LeoAndGit/Soft_Robot_Controller/PCB/SoftRobotExpansion-01.pdf

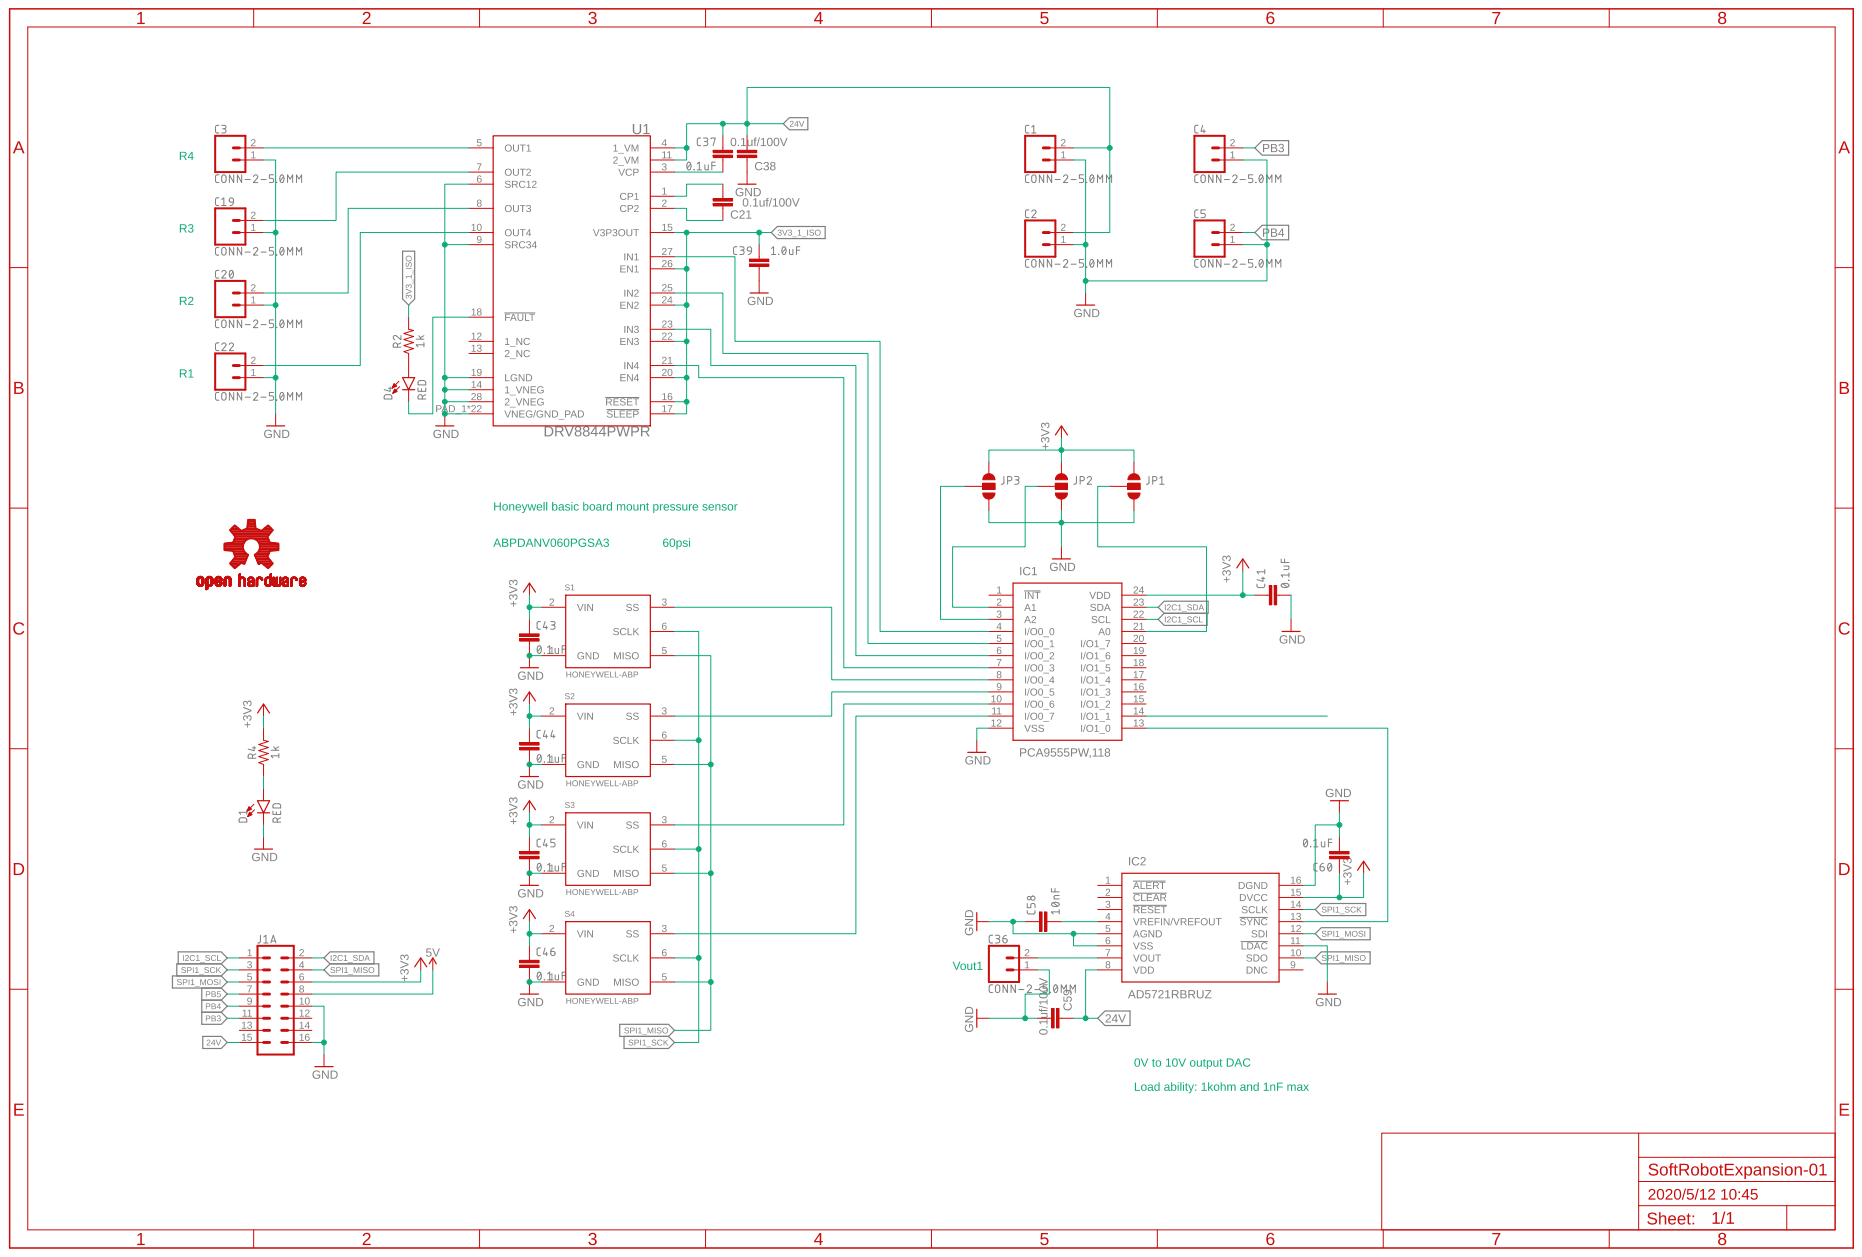
[picture p3: page 1]
