LeoAndGit/Soft_Robot_Controller/PCB/SoftRobotController-01.pdf

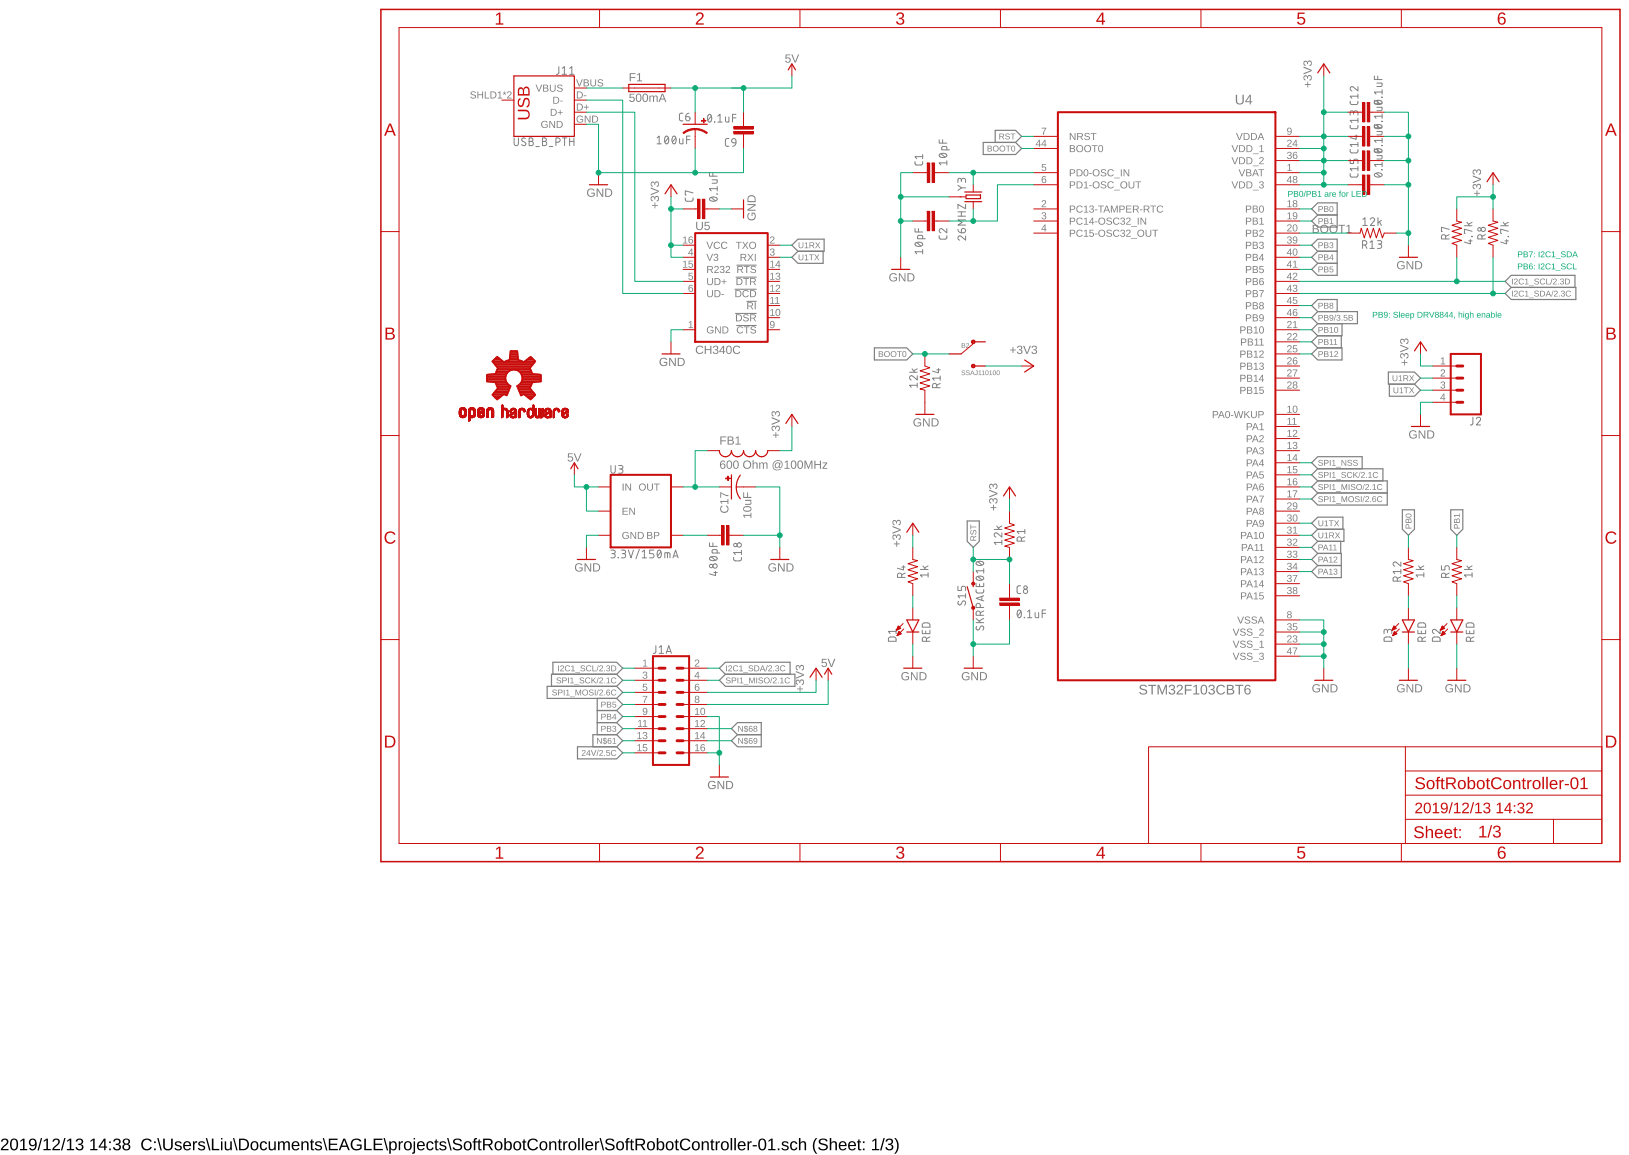
[picture p4: page 1]

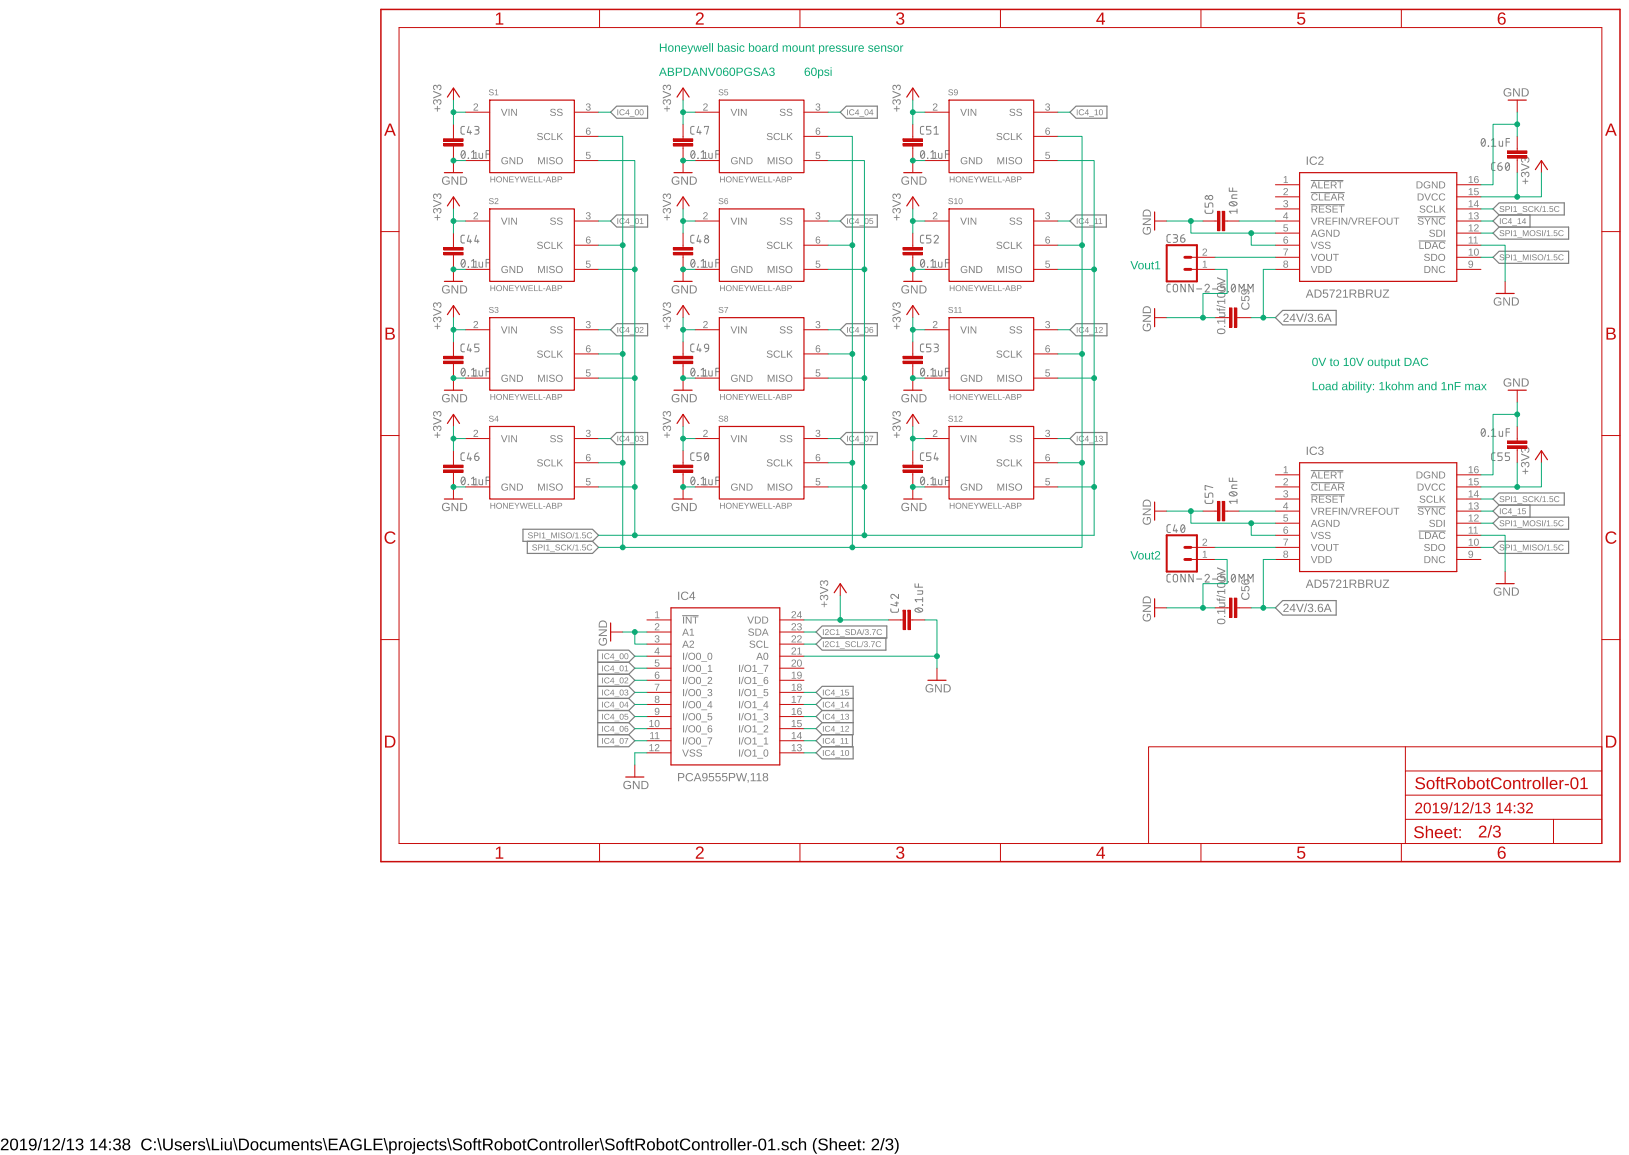
[picture p5: page 2]

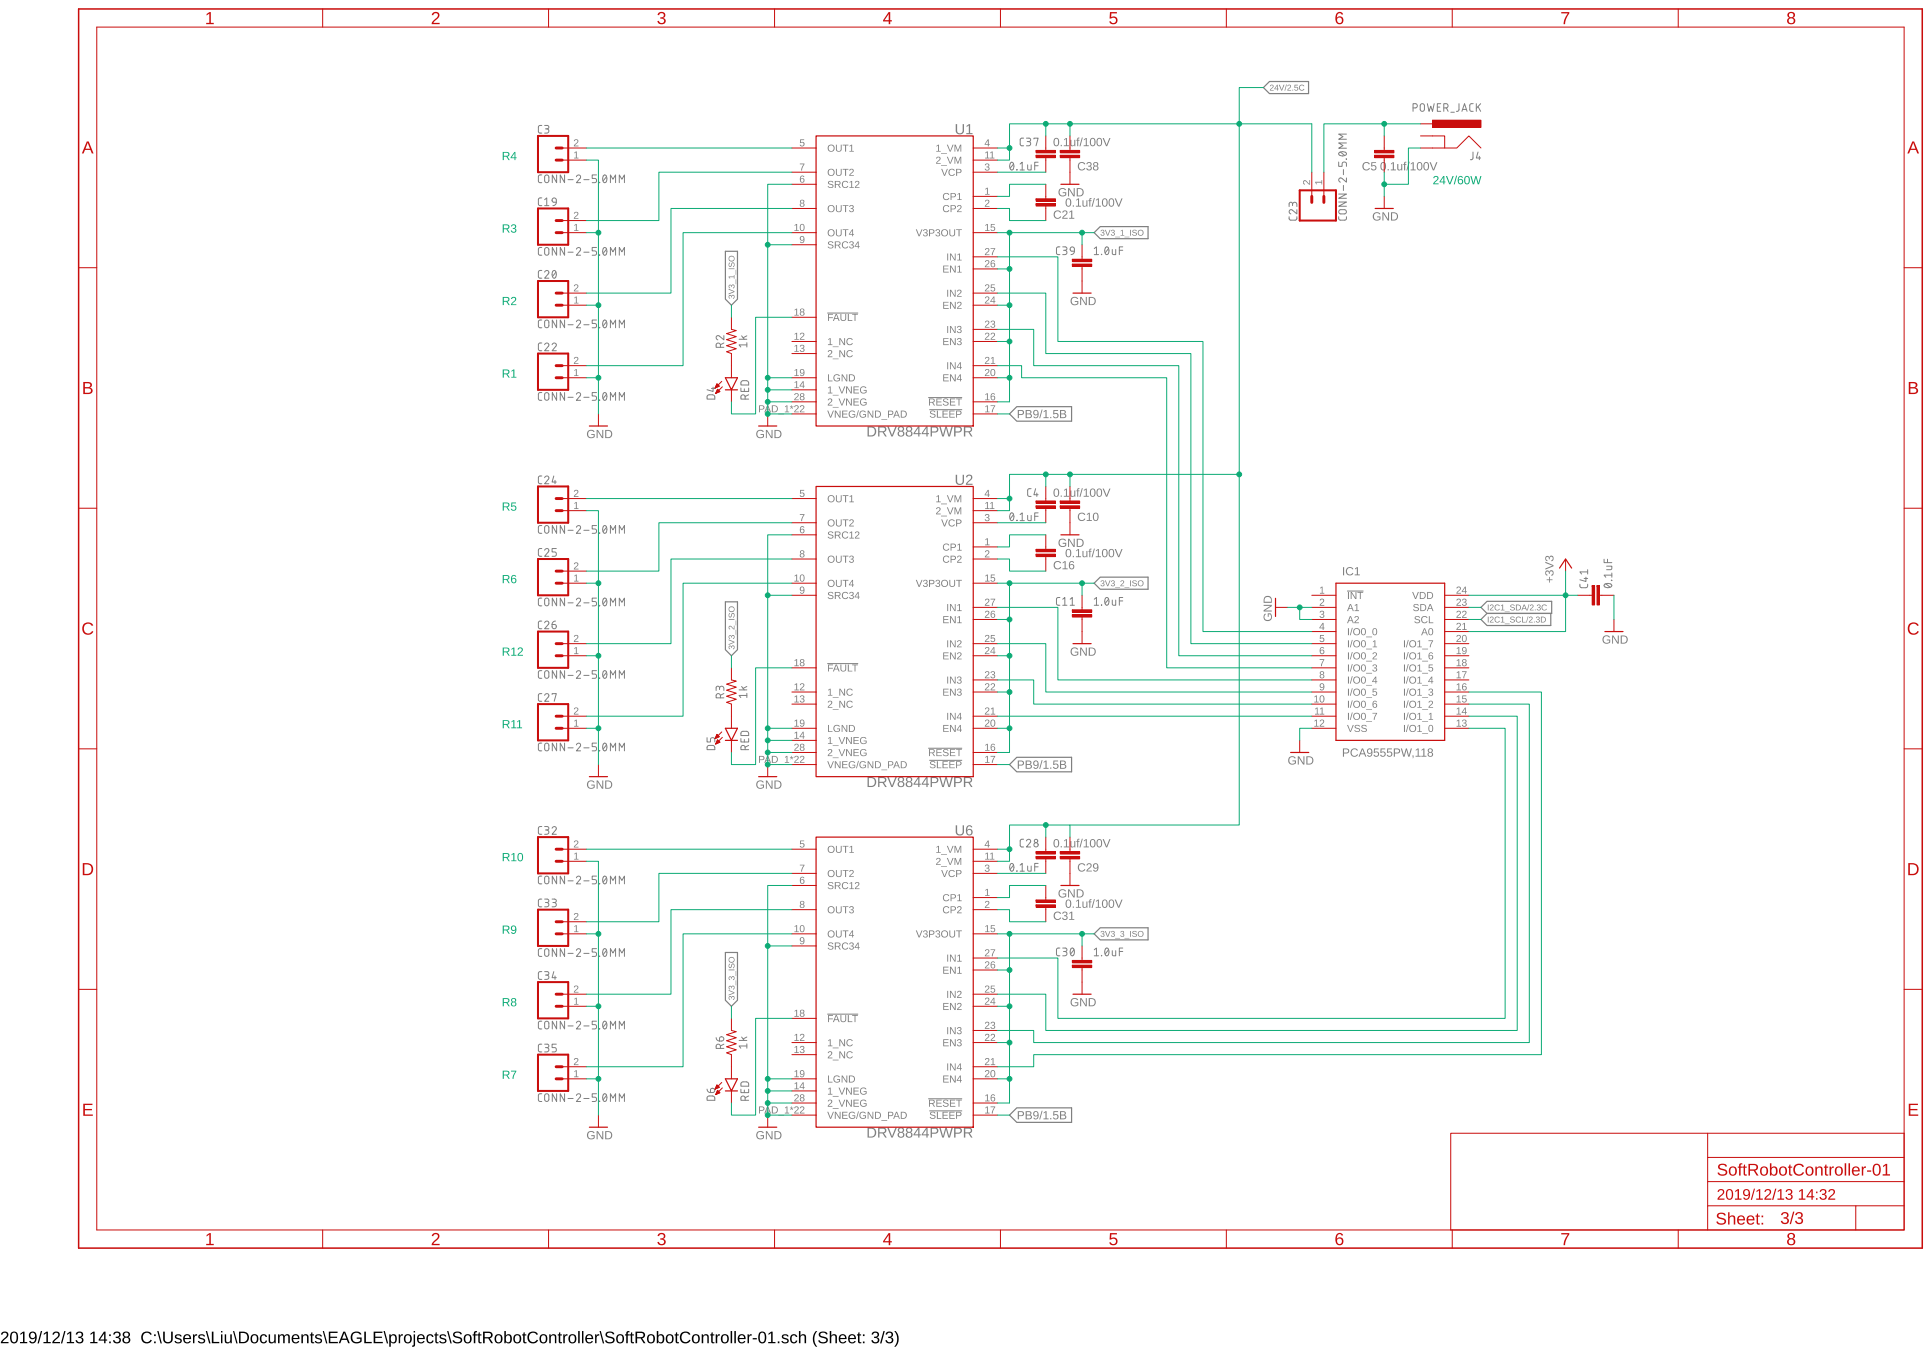
[picture p6: page 3]
